Corvaxdev/uno-mini-air/docs/ILLUSTRATIONS.md

# Assembly and engineering diagrams

Original assembly photographs supplied by Corvaxdev, unchanged. No generated
hardware or composited components. These media files document the current stand.

Assembly overview
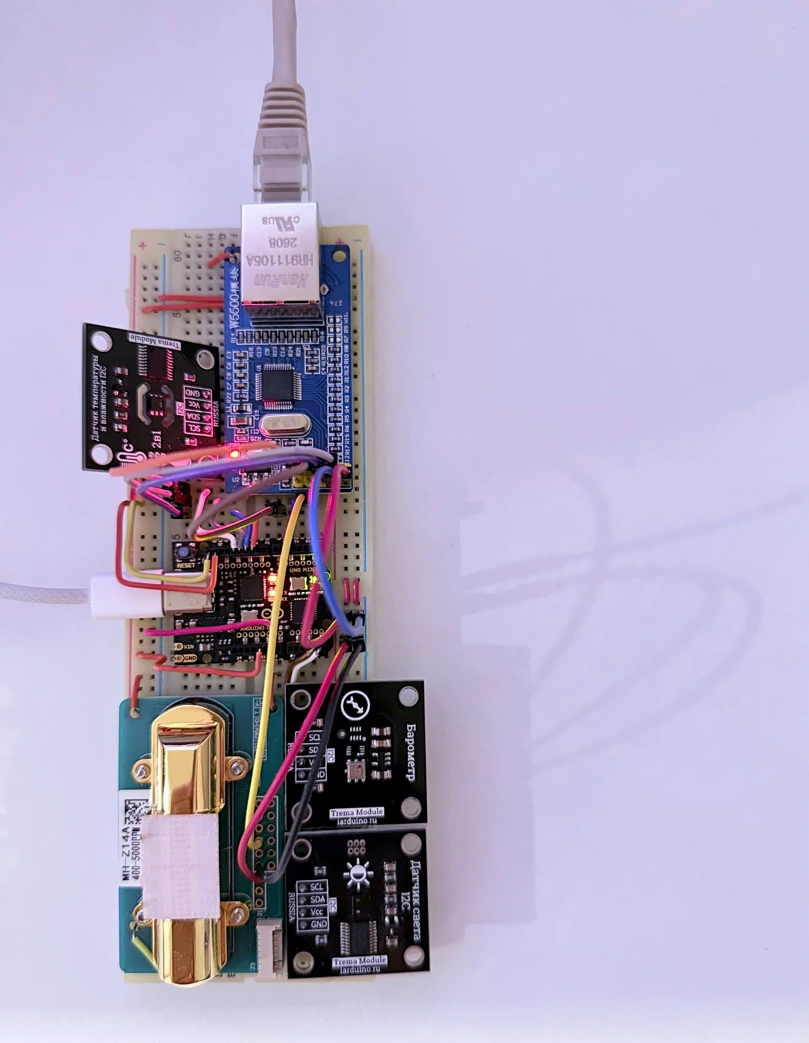
[picture p2: media/assembly-01.jpg]
Overhead wiring

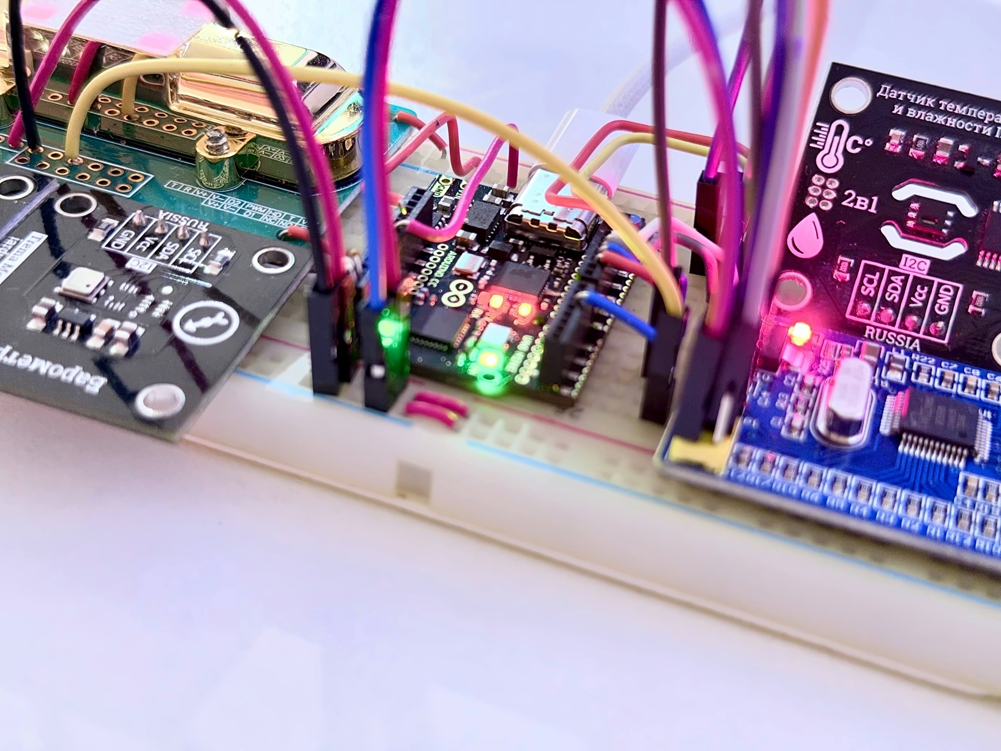
[picture p3: media/assembly-02.jpg]
UNO Mini close-up


## Engineering diagrams

The memory figure describes the independently compiled public 0.12.9 source
edition. Production sizes differ; see README. A response body is not a TCP packet.

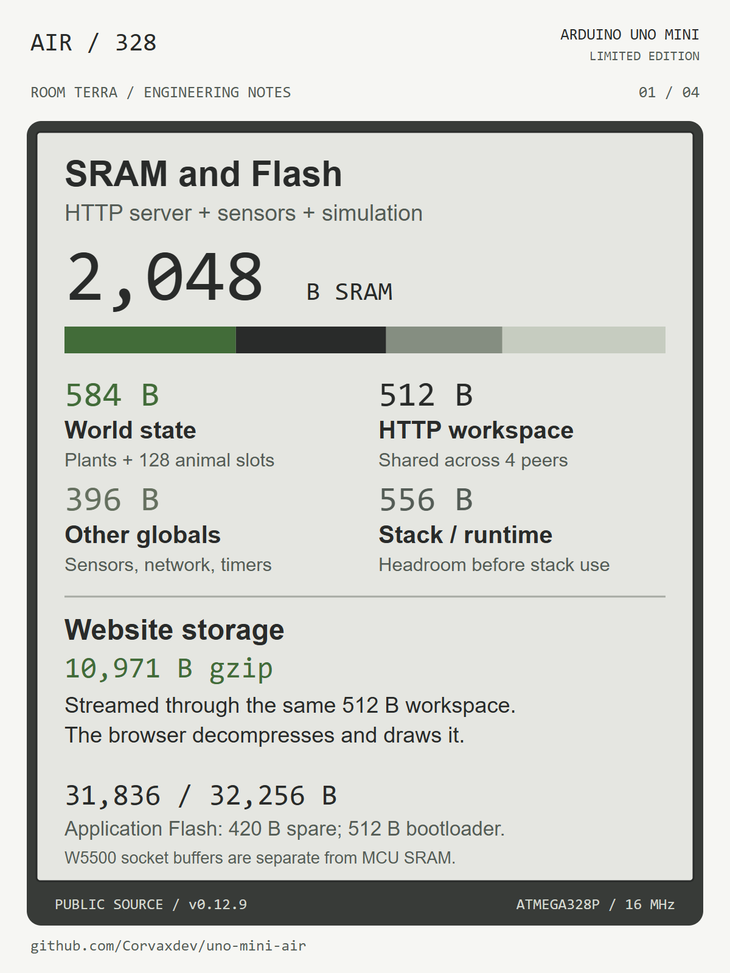
[picture p4: media/01-memory.png]
Memory allocation

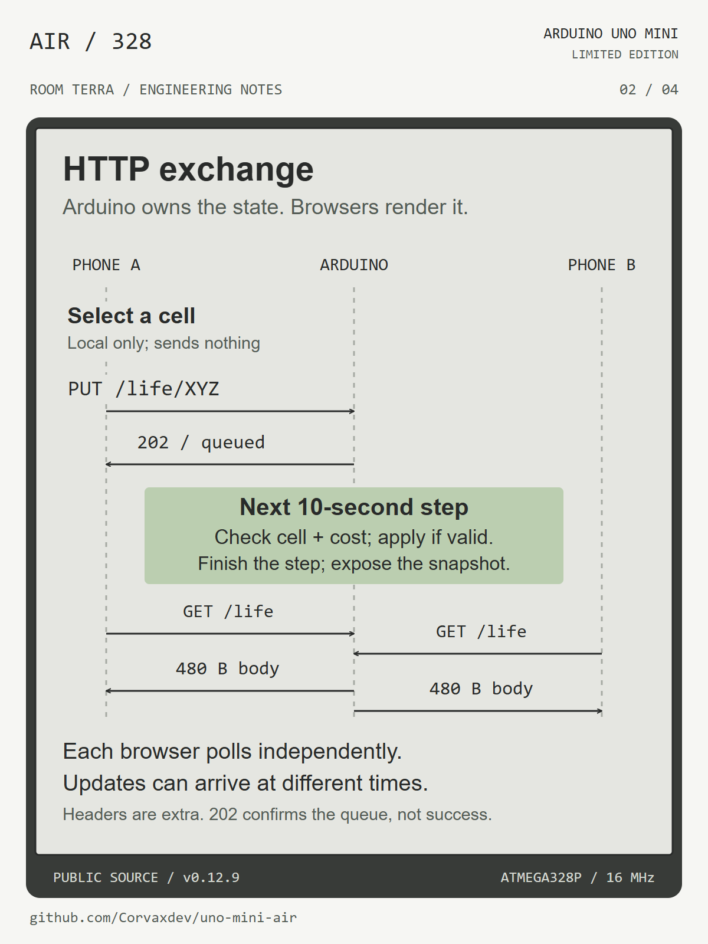
[picture p5: media/02-exchange.png]
Client/server HTTP exchange

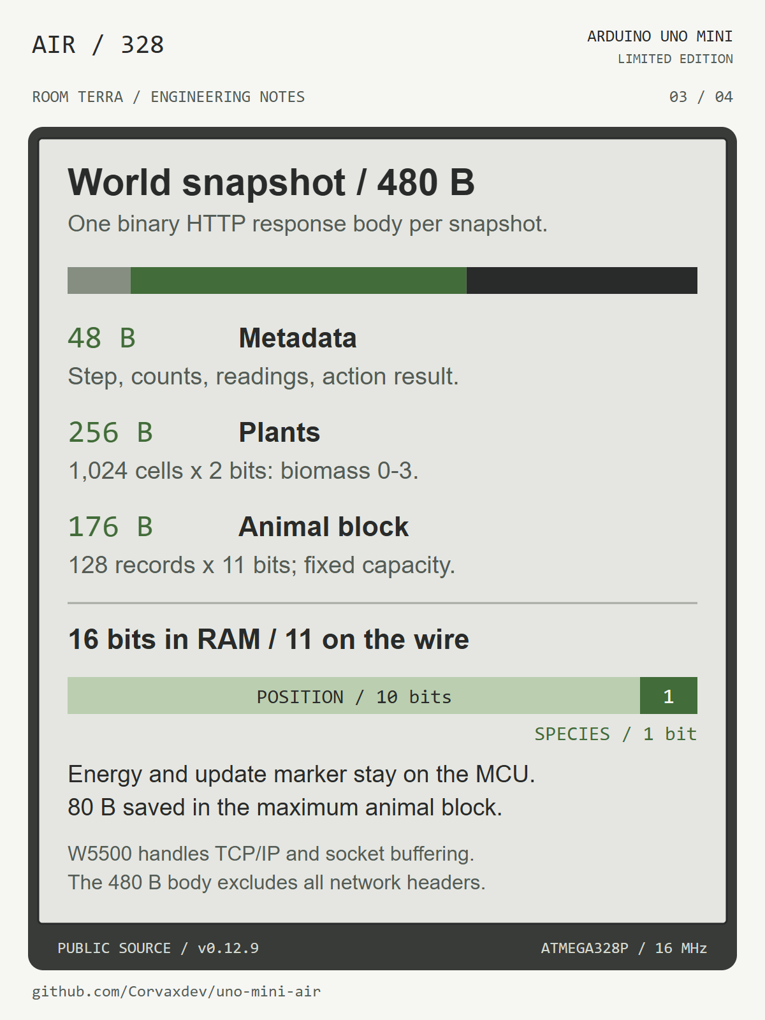
[picture p6: media/03-packing.png]
Binary snapshot layout

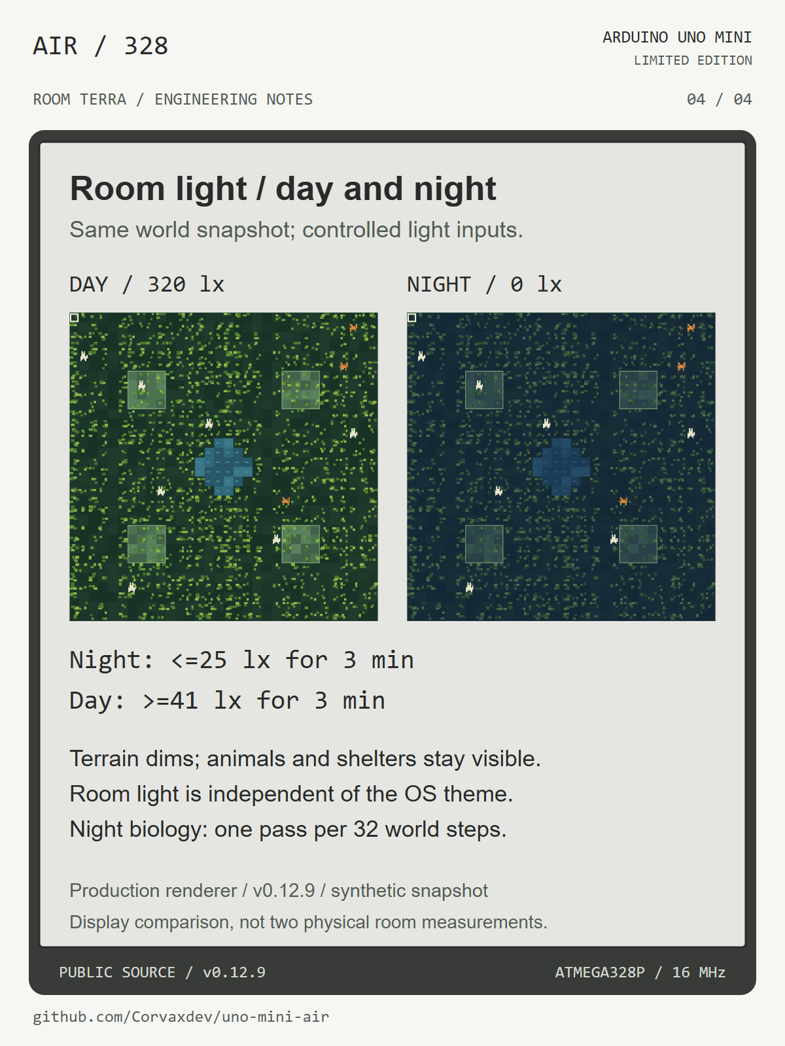
[picture p7: media/04-light.png]
Controlled room-light comparison


The lighting images use the production renderer, the same synthetic world and
controlled 320/0 lx inputs. They illustrate the display, not two measured room
states. [Full screenshots and thresholds](DAY-NIGHT.md).

SVG sources accompany the PNG files. Text and arithmetic are explicit,
programmatically checked and visually reviewed; not generated inside a raster image.

Placement fix 0.12.10: see [checks](../evidence/placement-01210.json). Diagrams, day/night images and model/load measurements remain versioned 0.12.9 or earlier; their labels identify the measured revision. Current build sizes are in the root README and evidence/public-build.json.
