Corvaxdev/uno-mini-air/requirements-build.txt

zopfli==0.4.1
# Optional, only for make_font.py without --compact: fonttools / brotli.
