Corvaxdev/uno-mini-air/(commit log)

2026-09-29 Publish AIR / 328: UNO Mini HTTP server, sensors and Room Terra
    [actual_room.csv, co2_1000.csv, co2_2000.csv, co2_5000.csv, cycles_72h.csv, day_night.csv, fresh.csv, missing_co2.csv]
2026-09-29 Publish Terra 0.12.9 with room-light model, tests and verified documentation
    [continuous_day.csv, continuous_night.csv, dim_cycle.csv, excess_light.csv, normal_cycle.csv, room_cycle.csv]
2026-09-29 Fix water placement in Terra UI and MCU action validation
    [Terra.h, placement.cpp, run.py]
2026-09-29 Fix polling lifecycle, Terra controls and EEPROM fault recovery
    [ViewJournal.h, journal-faults.cpp, journal.cpp, run.py]
2026-09-29 Fix W5500 RX count race and bound receive copies
    [AirSocket.h, run.py, rx-race.cpp]
2026-09-30 Fix HTTP deadlines, rollover and stale action feedback; trim sensor state
    [Terra.h, UnoMiniEthernet.ino, http-state-template.cpp, math.cpp, recovery.cpp, run.py]
